alf64/prj-gardmer/releases/hw/mb/prj-gardmer-mb-v2/rev001/pdf/pcb/BOTTOM-elems.pdf

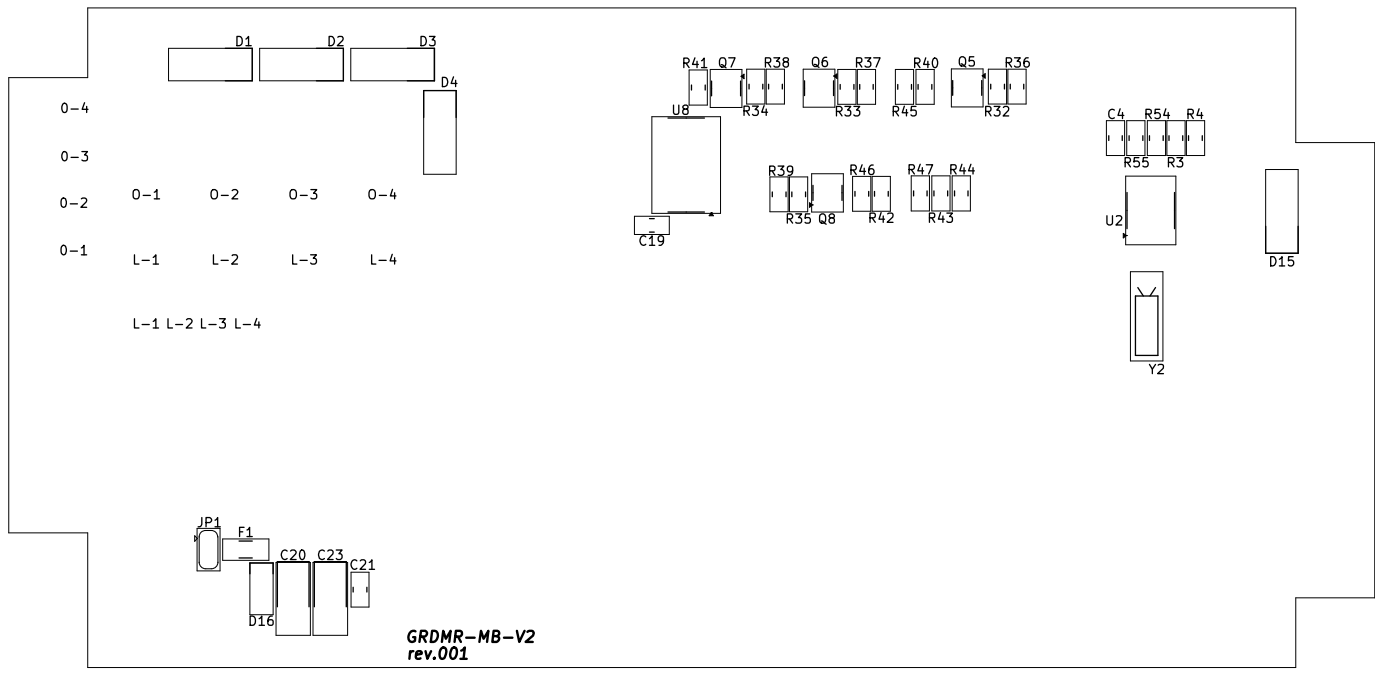
[picture p1: page 1]
