alf64/prj-gardmer/releases/hw/mb/prj-gardmer-mb-v2/rev001/pdf/pcb/TOP-elems.pdf

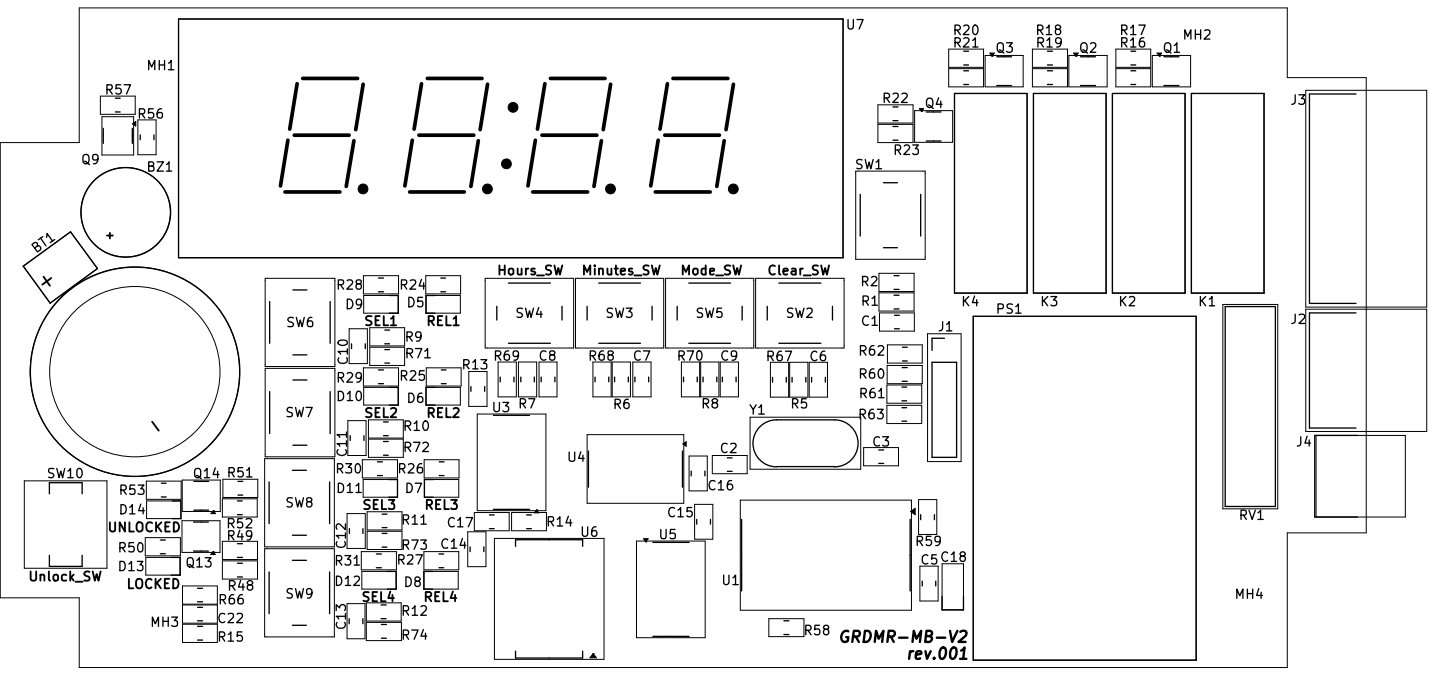
[picture p2: page 1]
