alf64/prj-gardmer/releases/hw/mb/prj-gardmer-mb-v2/rev001/pdf/sch/prj-gardmer-mb-v2-rev001.pdf

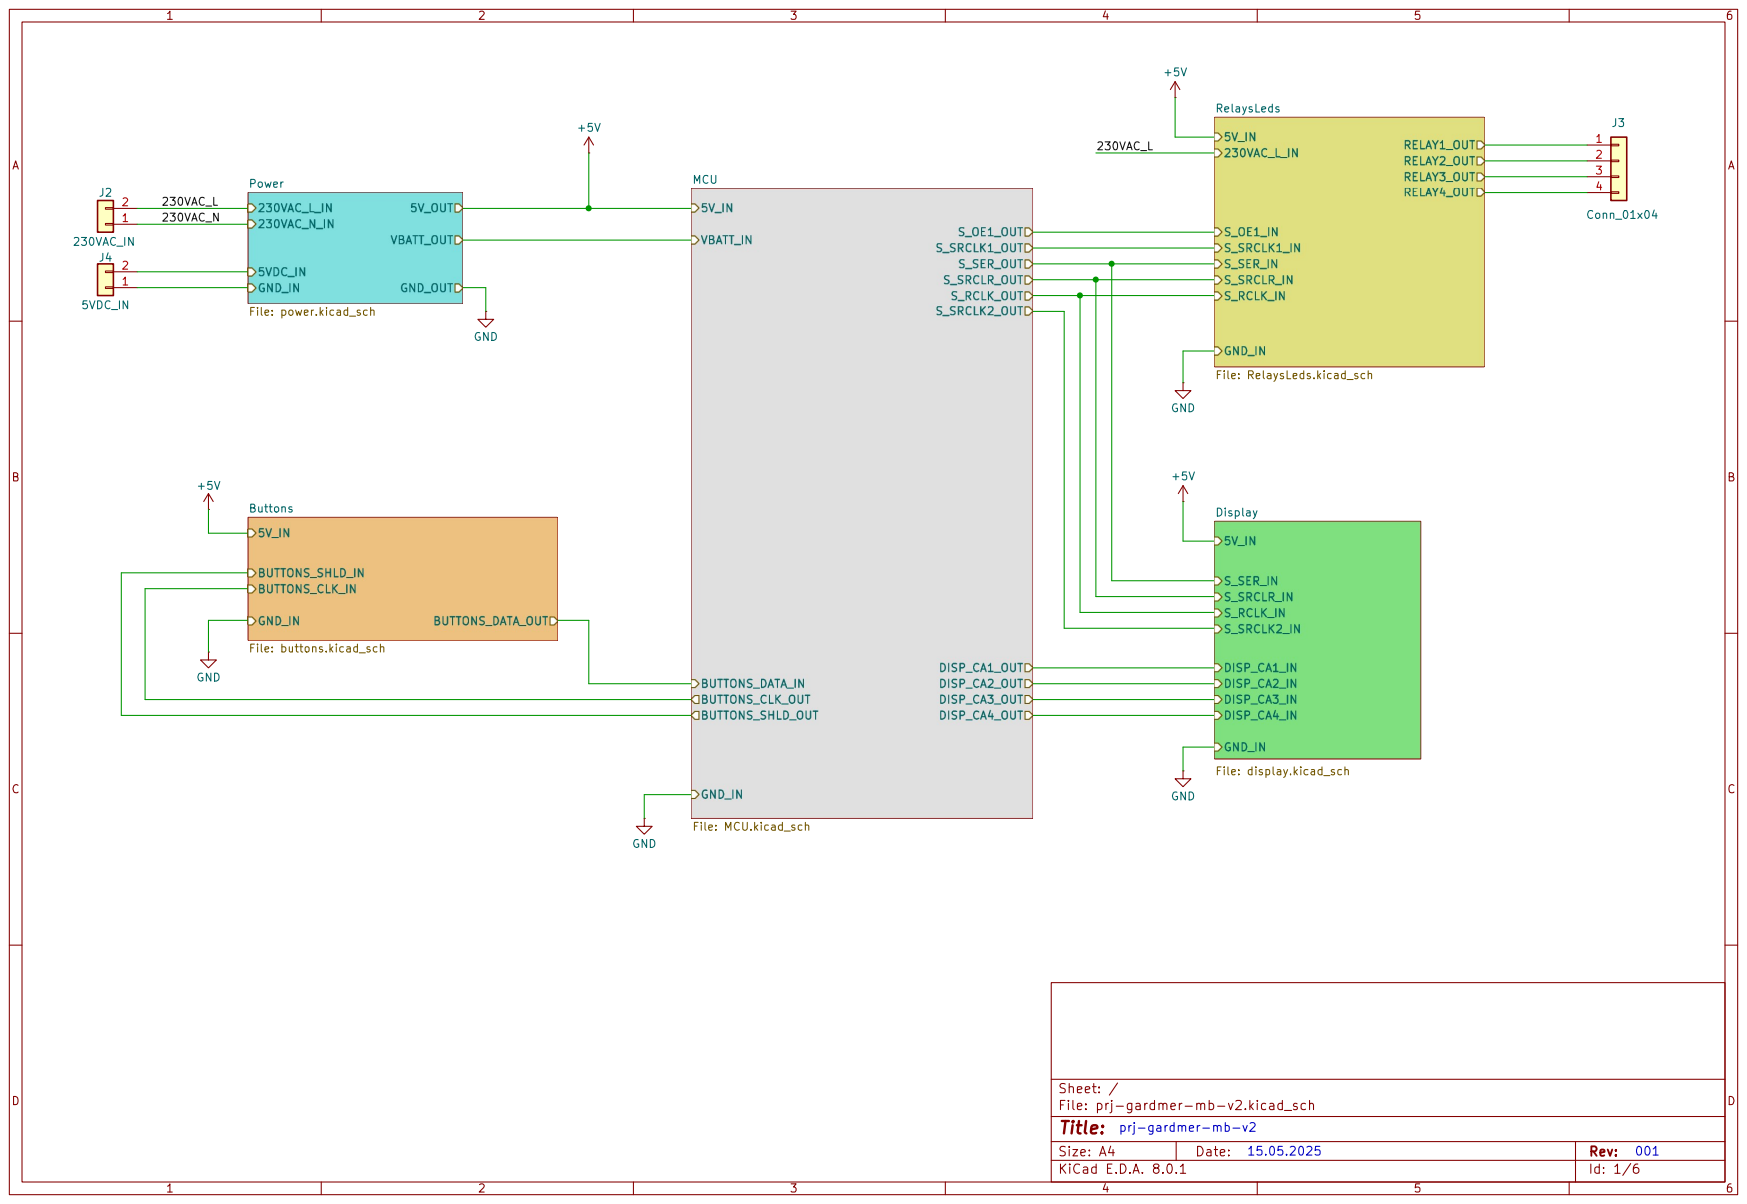
[picture p3: page 1]

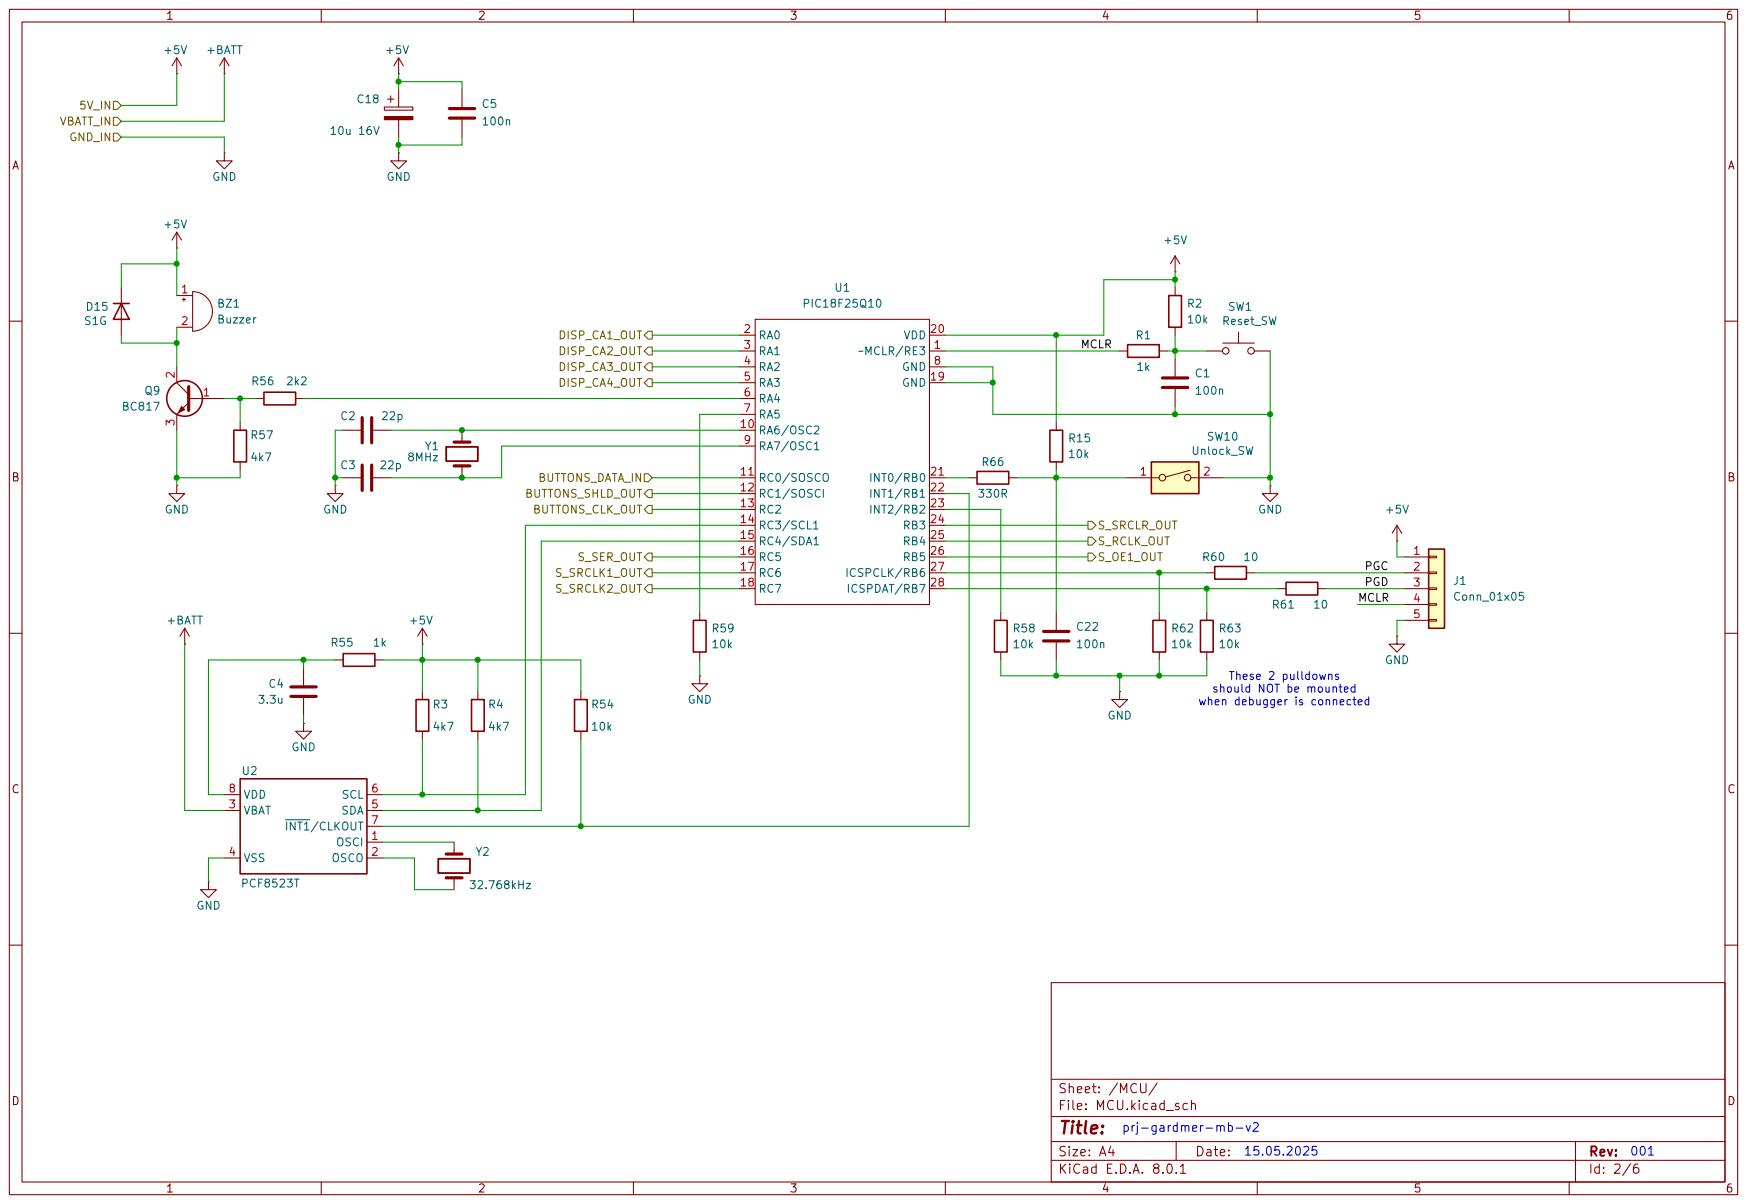
[picture p4: page 2]

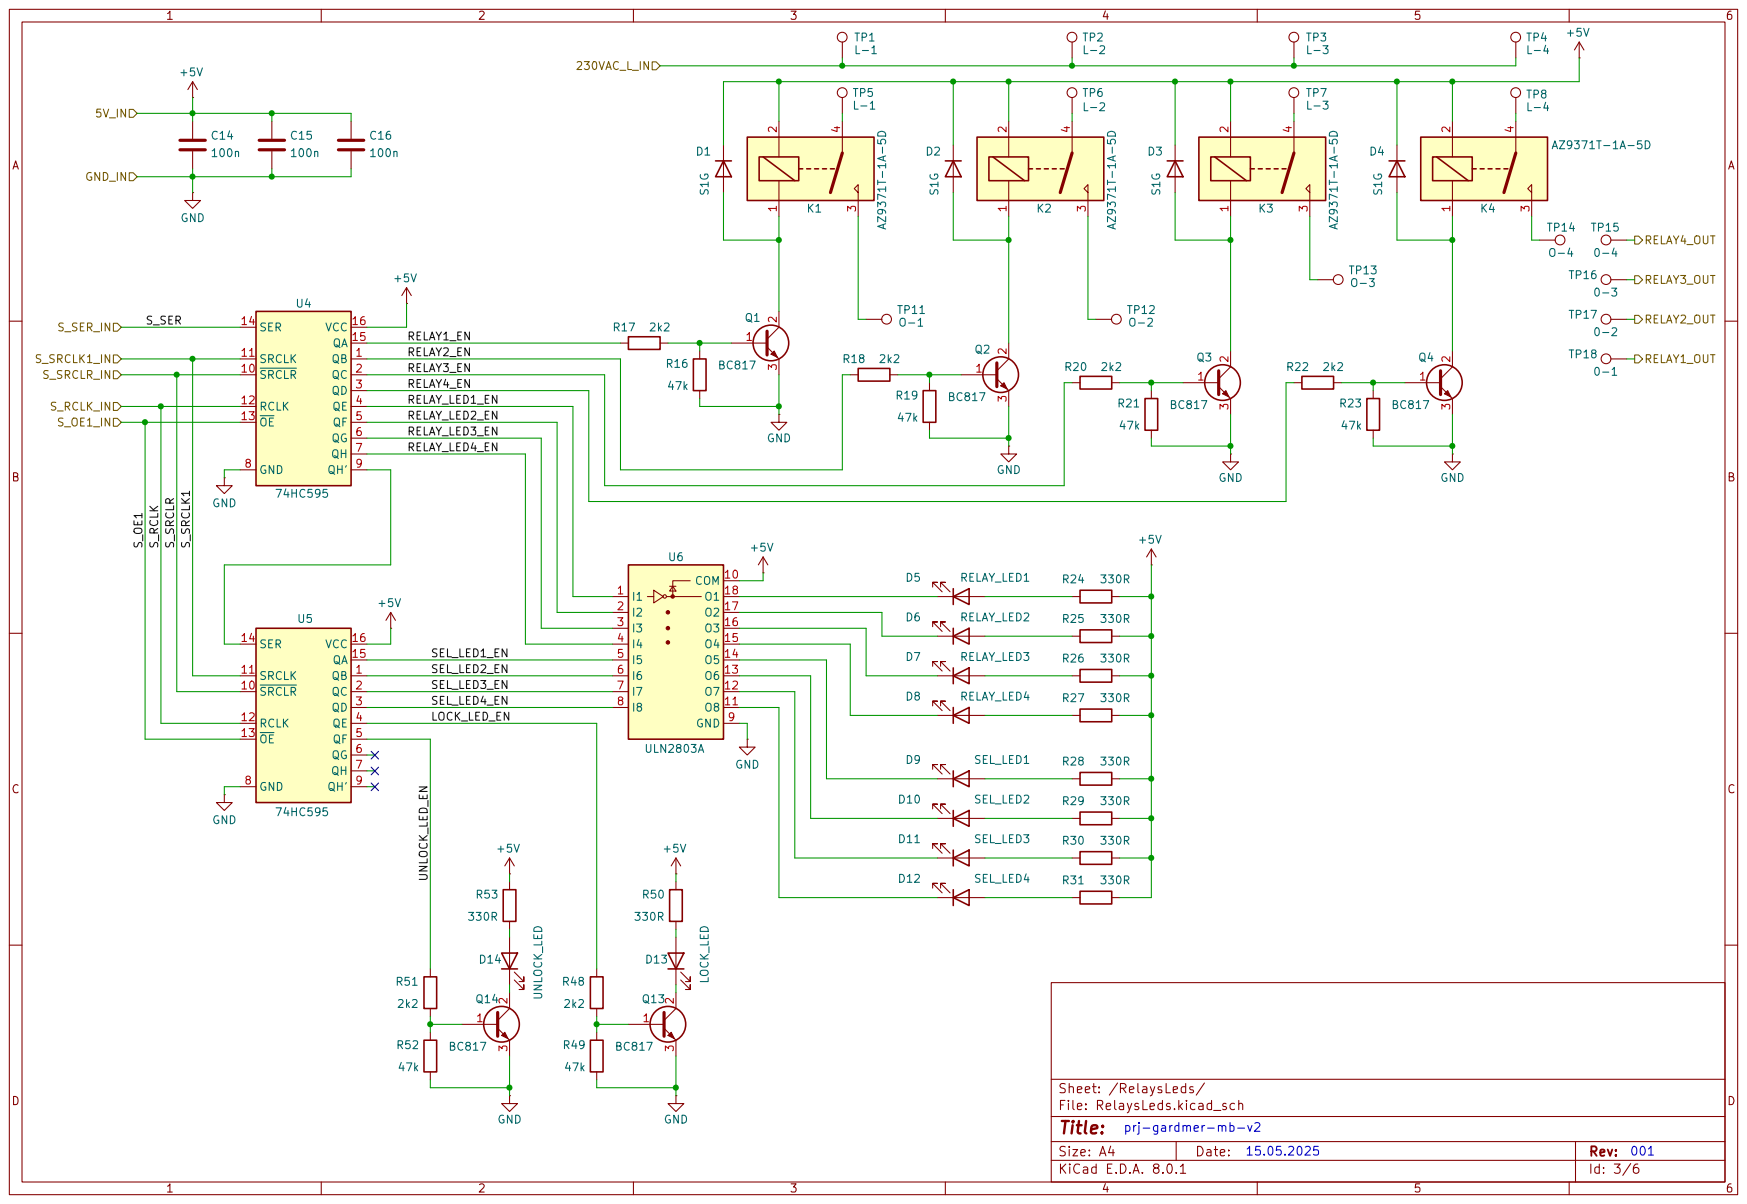
[picture p5: page 3]

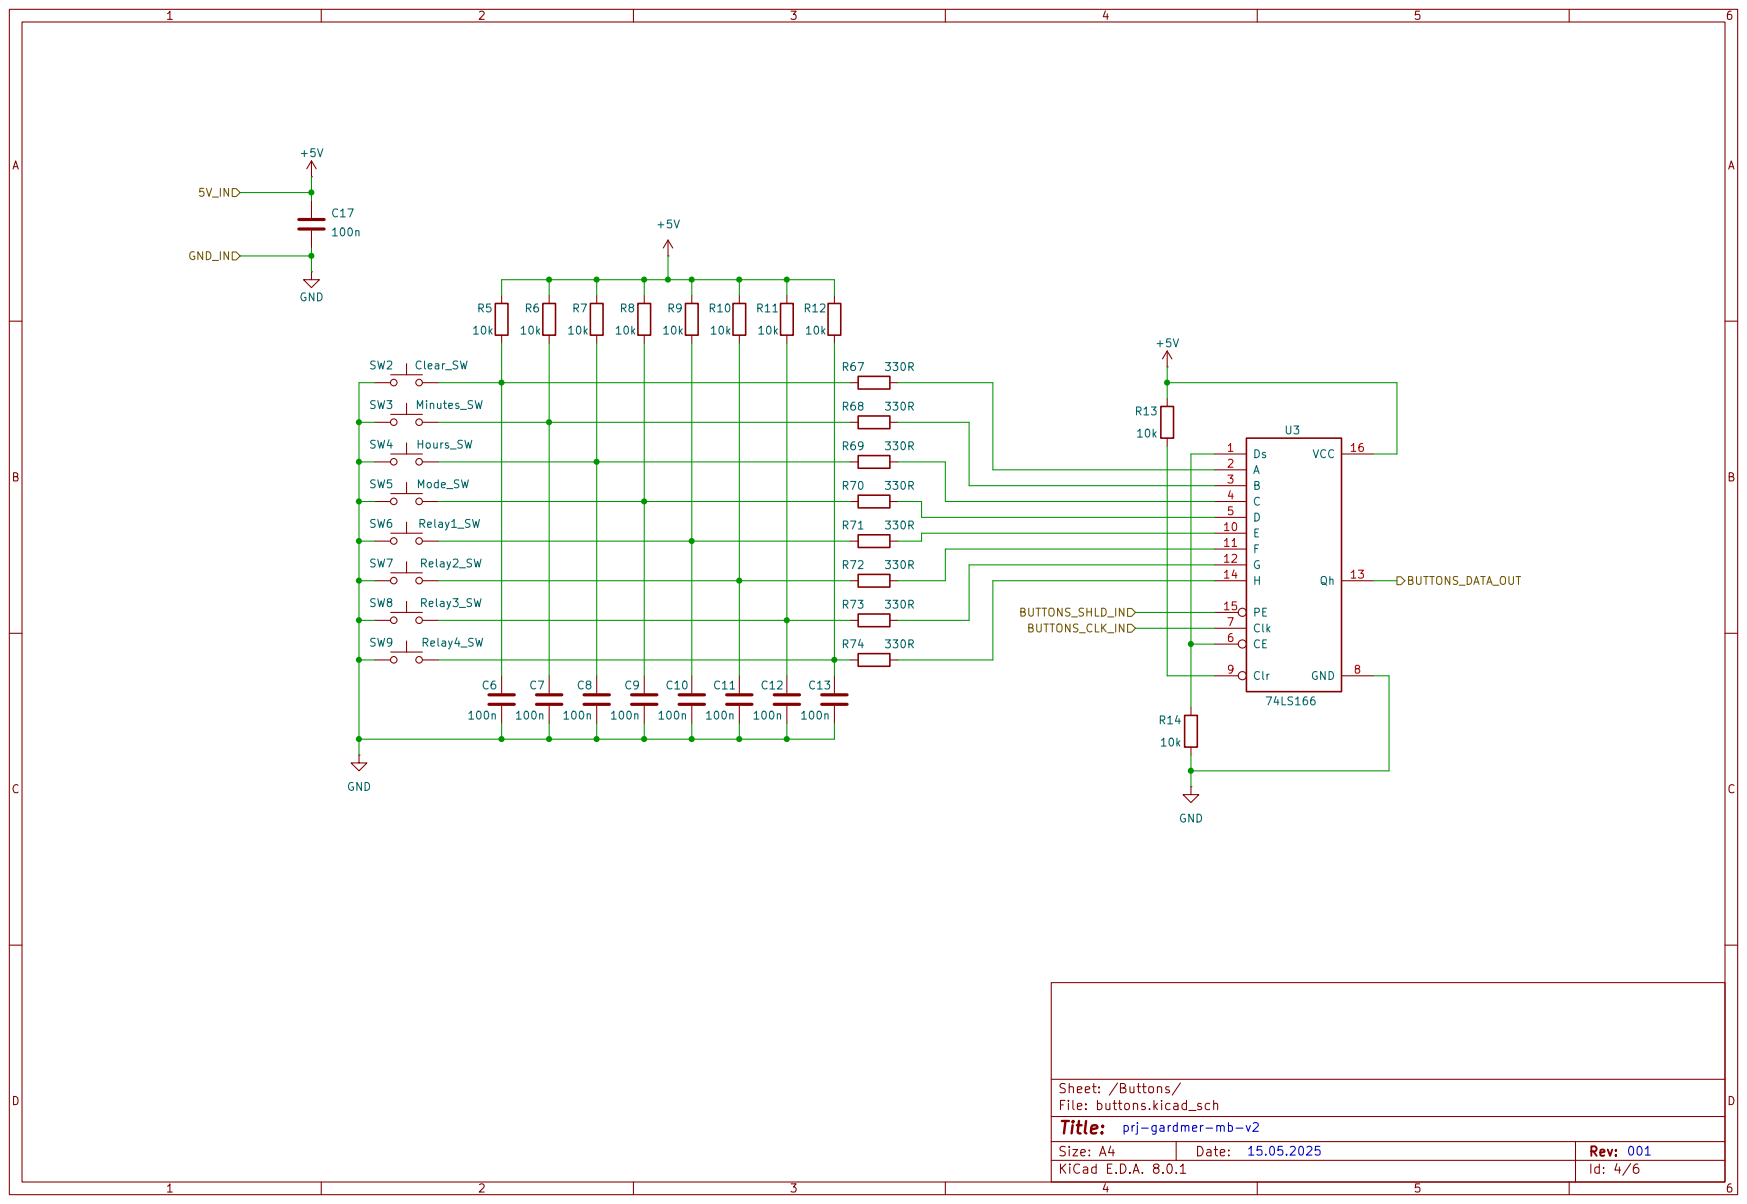
[picture p6: page 4]

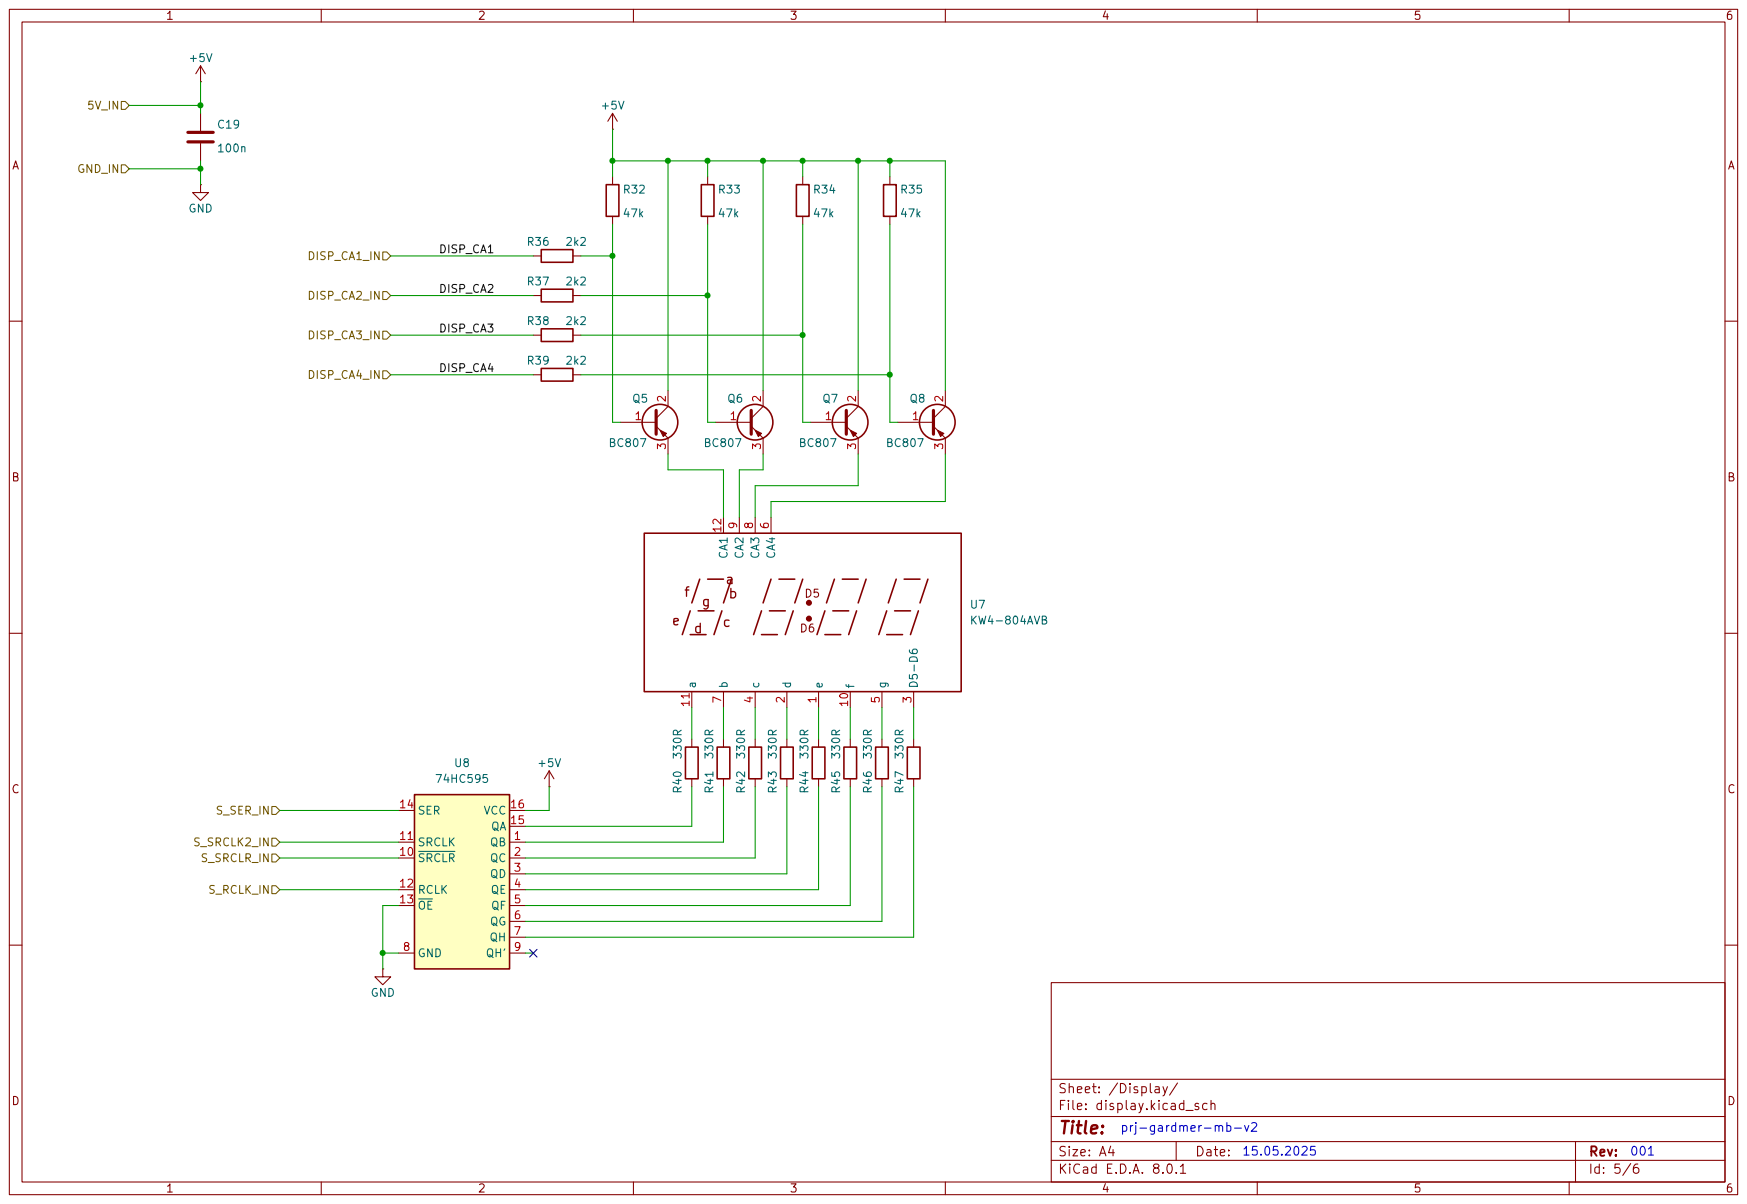
[picture p7: page 5]

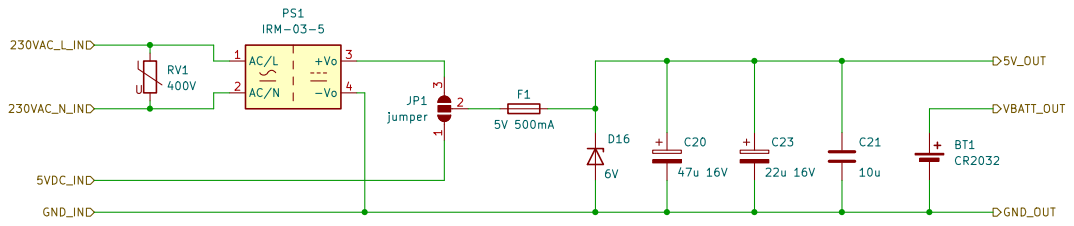
[picture p8: page 6]
