alf64/prj-gardmer/hw/mb/prj-gardmer-mb/v1-schematic.pdf

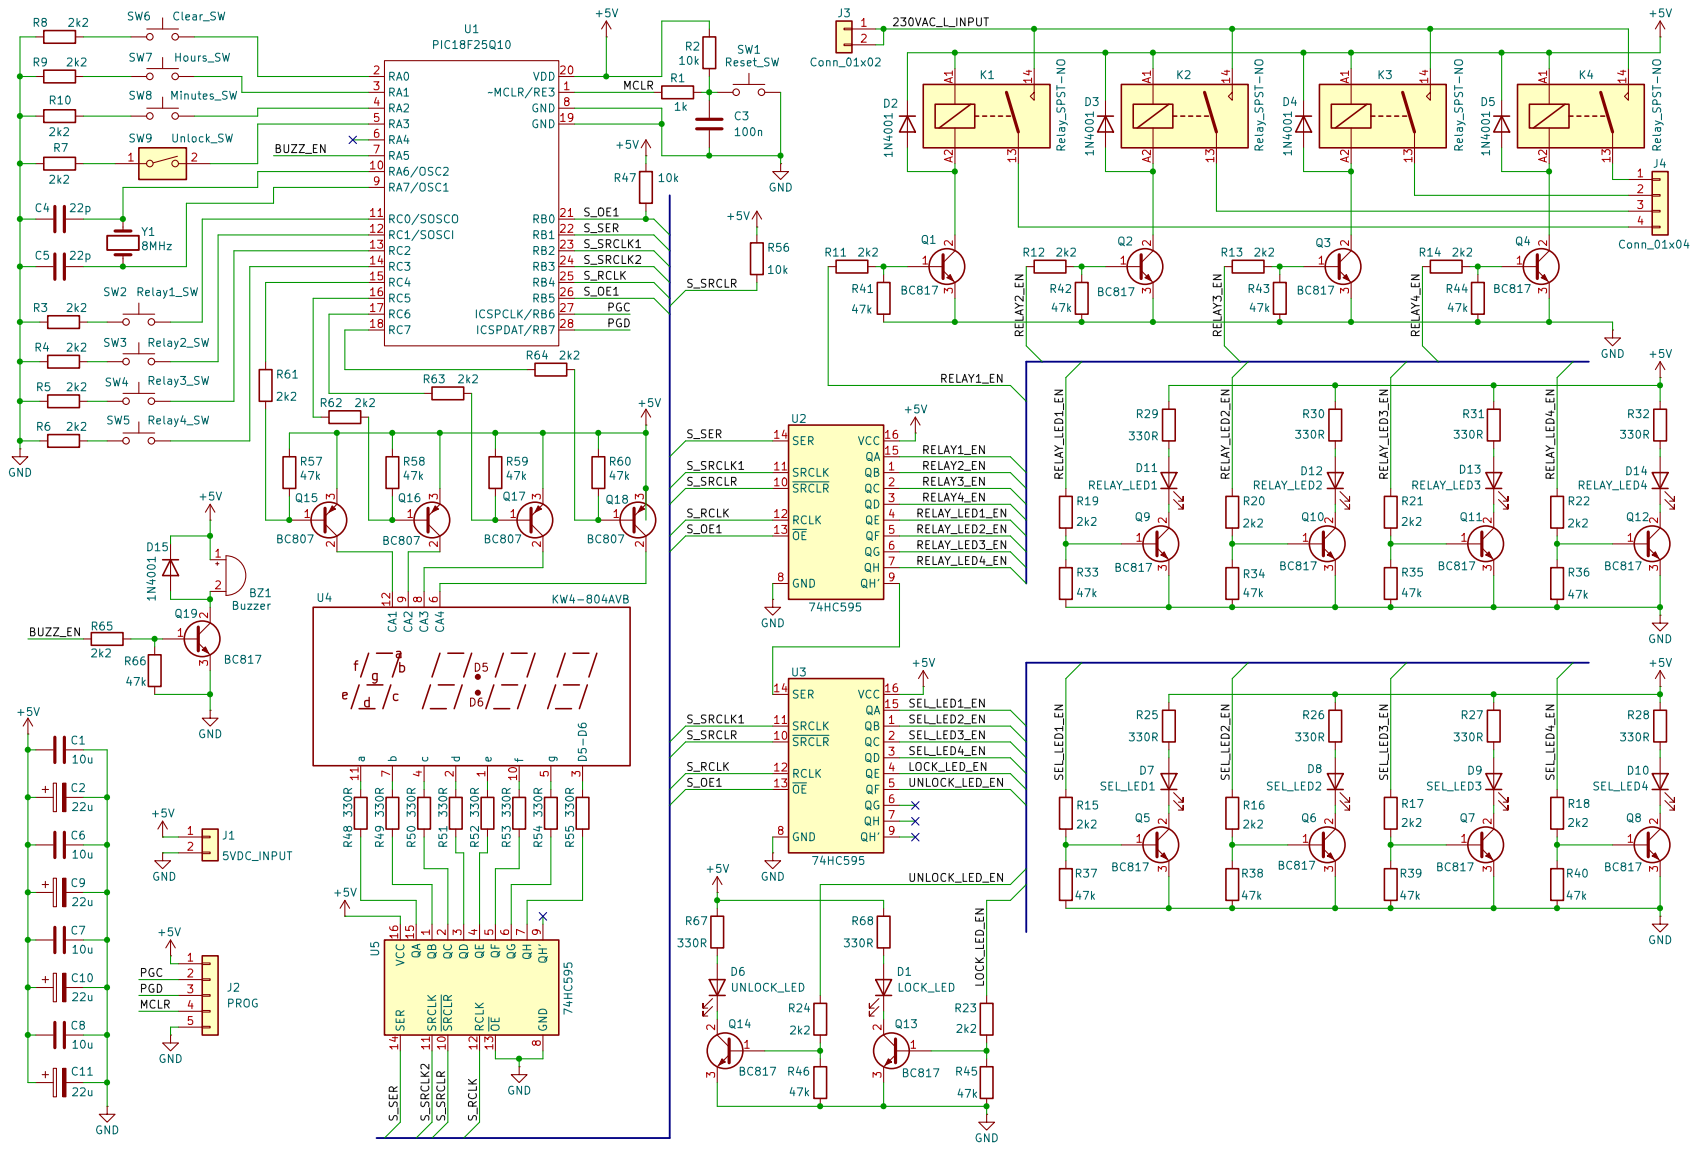
[picture p9: page 1]
