alf64/prj-gardmer/(commit log)

2024-10-20 Added schematics.
    [MCU.kicad_sch, RelaysLeds.kicad_sch, buttons.kicad_sch, display.kicad_sch, power.kicad_sch, prj-gardmer-mb-edited.csv, prj-gardmer-mb-v2.kicad_pcb, prj-gardmer-mb-v2.kicad_sch]
2025-01-12 Added footprints and bom. Updated schematics.
    [MCU.kicad_sch, RelaysLeds.kicad_sch, buttons.kicad_sch, power.kicad_sch, prj-gardmer-mb-v2.csv, prj-gardmer-mb-v2.kicad_sch]
2025-01-13 Assigned footprints to schematic symbols.
    [MCU.kicad_sch, RelaysLeds.kicad_sch, buttons.kicad_sch, display.kicad_sch, power.kicad_sch, prj-gardmer-mb-v2.kicad_sch]
2025-01-13 Updated PCB with schematic.
    [prj-gardmer-mb-v2.kicad_pcb]
2025-01-27 Updated PCB: initially placed elements. Added footprints: holes 4.2mm, 4.4mm and 4.6mm.
    [prj-gardmer-mb-v2.kicad_pcb]
2025-03-09 Updated schematic: - added test points instead of connections between relays and outputs - fixed crystal connection for rtc
    Updated PCB:
    - halfway through the routing
    Updated footprints:
    - added footprints for test points
    - reduced size of pads for D_SMA
    [MCU.kicad_sch, RelaysLeds.kicad_sch, prj-gardmer-mb-v2.kicad_pcb, prj-gardmer-mb-v2.kicad_sch]
2025-03-12 Updated footprints: - changed diodes footprints pad numbers, so the diode 'bar' (cathode) now points to the silkscreen mark
    - updated all diode footprints
    - fixed board outline (it was not closed), so the 3D view now presents correct board shape
    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
    [prj-gardmer-mb-v2.kicad_pcb]
2025-03-13 Updated schematic (footprints assign), PCB and footprints: - Changed the 'Generic' footprints that were used for capacitors, resistors and fuses into specific ones (I.e. Generic_0805 is replaced by C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
    [MCU.kicad_sch, RelaysLeds.kicad_sch, buttons.kicad_sch, display.kicad_sch, power.kicad_sch, prj-gardmer-mb-v2.kicad_pcb]
2025-03-24 Updated PCB: - signal traces routed
    [prj-gardmer-mb-v2.kicad_pcb]
2025-04-03 Updated PCB: - 5V line routed
    [prj-gardmer-mb-v2.kicad_pcb]
2025-04-15 Updated PCB: - GND line routed
    [prj-gardmer-mb-v2.kicad_pcb]
2025-04-16 Updated footprint: - KW4-804AVB - removed the digits from F.Courtyyard layer, because DRC was complaining about them
    - Updated footprints (KW4-804AVB, cr2032 holder) with footprint library
    - disabled removing redundant tracks at routing options (to allow multiple vias on the same track)
    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
    [prj-gardmer-mb-v2.kicad_pcb]
2025-04-23 Updated PCB: - improved 5V vias (they are now bigger and their pairs are connected on both layers in a prettier manner)
    [prj-gardmer-mb-v2.kicad_pcb]
2025-04-29 Updated PCB: - GND polygons poured - optimized tracks routing
    - crc2032 holder mounting holes/pads has now copper removed
    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
    [prj-gardmer-mb-v2.kicad_pcb]
2025-04-30 Updated PCB: - GND polygons optimized by adding essential vias and improving routing of few tracks
    [prj-gardmer-mb-v2.kicad_pcb]
2025-05-05 Updated PCB: - filled GND planes with vias - added board name and revision on the silkscreen layer, at the bottom right corner of the board
    [prj-gardmer-mb-v2.kicad_pcb]
2025-05-05 Updated PCB: - added teardrops to pads and vias
    [prj-gardmer-mb-v2.kicad_pcb]
2025-05-06 Updated PCB: - D16 reference on silkscreen properties change - 'Keep upright' selected, so it now displays correctly - J2, J3, J4 footprints on board modified - silkscreen reduced to do not exceed th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
    [prj-gardmer-mb-v2.kicad_pcb]
2025-05-08 Updated PCB: - set soldermask expansion to 0.1mm (making the pads unmasked by 0.1mm more than their size)
    Created production (gerber) files.
    Created the release (rev001) of prj-gardmer-mb-v2 hardware.
    [grdmr-mb-v2-B_Cu.gbl, grdmr-mb-v2-B_Mask.gbs, grdmr-mb-v2-B_Silkscreen.gbo, grdmr-mb-v2-Edge_Cuts.gm1, grdmr-mb-v2-F_Cu.gtl, grdmr-mb-v2-F_Mask.gts, grdmr-mb-v2-F_Silkscreen.gto, grdmr-mb-v2-NPTH-drl_map.gbr]
2025-05-15 Updated the hw release of prj-gardmer-mb-v2 rev001: - reorganized files in catalogues - added schematic in .pdf - added top & bottom elements on pcb in .pdf - added bom
    Updated schematic:
    - added a title, rev and date to the drawing info table on each sheet
    - excluded test points ('TP' elements) from BOM
    - added a title, rev and date to the drawing info table
    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
    [MCU.kicad_sch, RelaysLeds.kicad_sch, buttons.kicad_sch, display.kicad_sch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]
